s-vesca/Bucaneve_first_try/README.md

# Bucaneve

<p align="center">
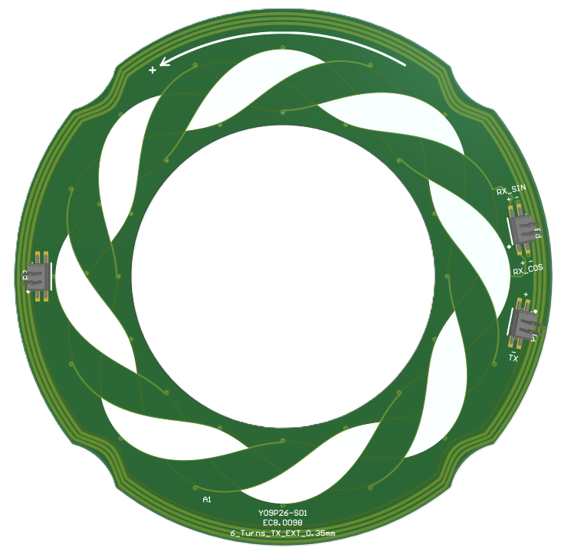
[picture p1: HW/coil_board/coil_board.png]
  
</p>
