s-vesca/Bucaneve_first_try/ppt_tecnomaster/tecnomaster_sensore_IPS.pptx

## Sensore IPS

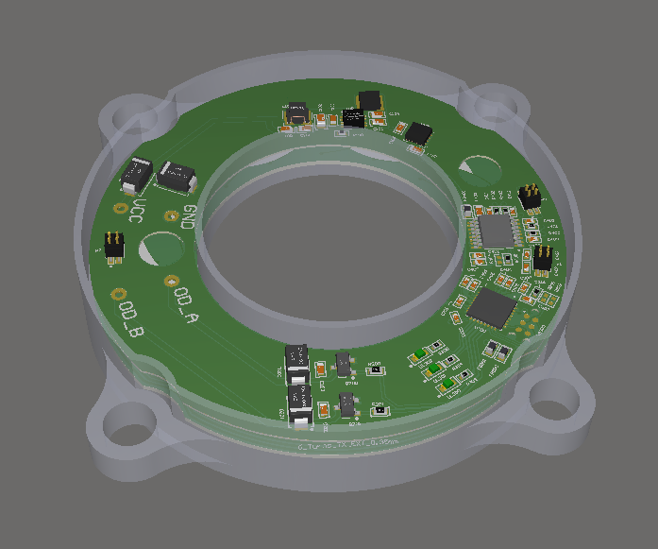
[picture p2: figure]
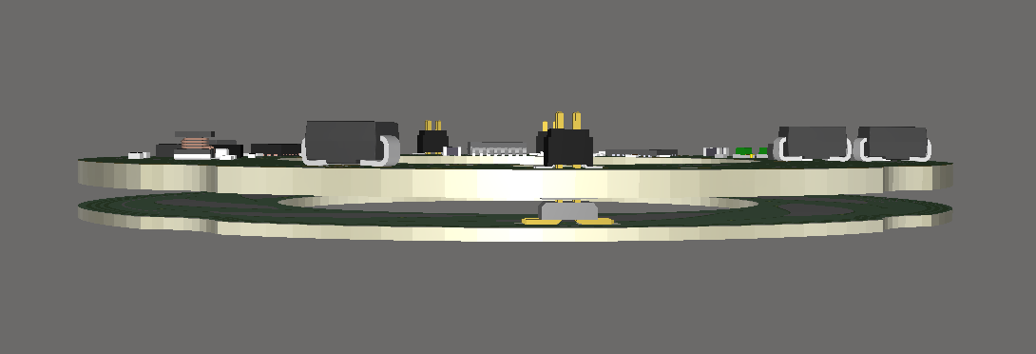
[picture p3: figure]

## Current Stackup

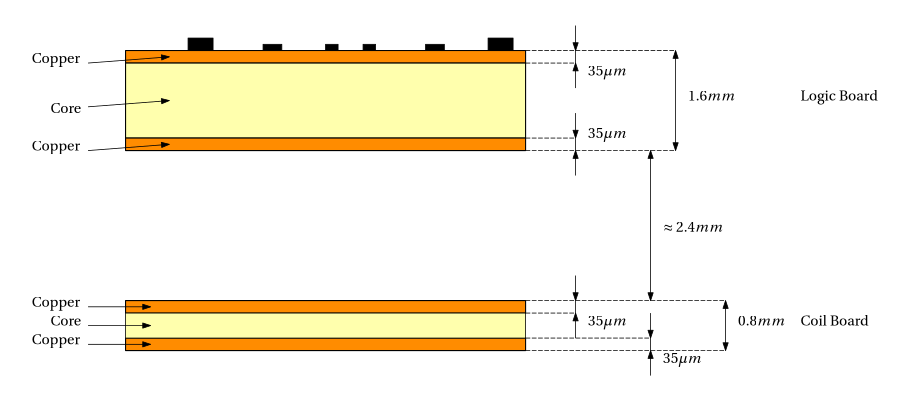
[picture p4: figure]

Cost: _____________________ €/$
(2 x 2 layer boards with all components on top layer)

Coupled via pin-strips

## Proposed Stackup

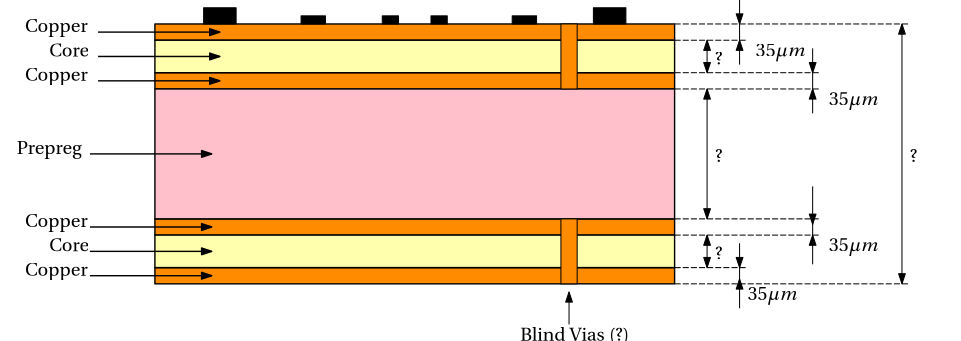
[picture p5: figure]

Maximize (?)

Cost: _____________________ €/$
(1 x 4 layer board with all components on top layer +
Blind vias Top – Inner 1 + Blind vias Inner 2 - Bottom)

Minimize (?)

## Slide 4

Proposed Stackup

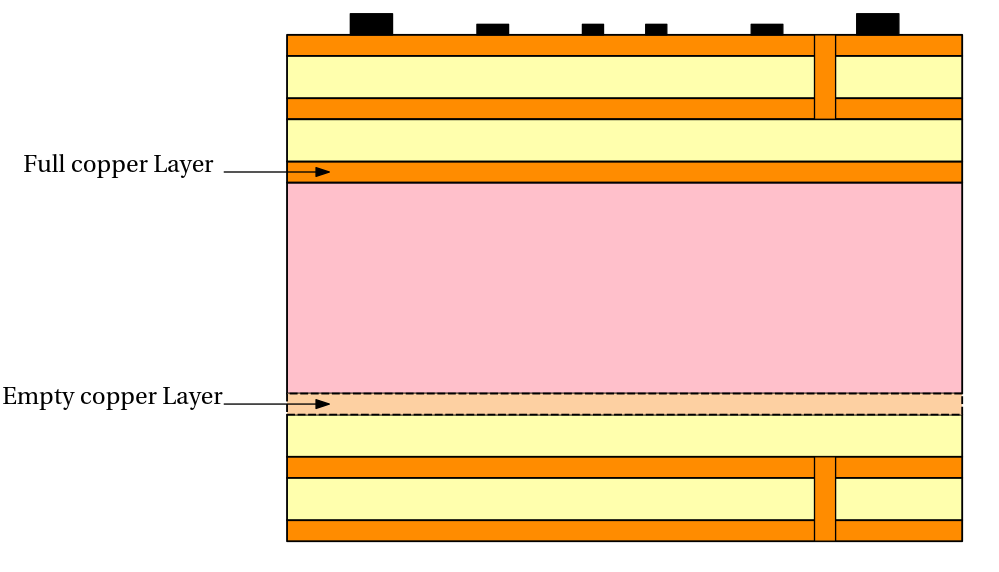
[picture p6: figure]

- Is this considered an asymmetric stackup?
- Is this feasible?

Full GND Plane

Avoid shielding of the coils
