s-vesca/Bucaneve_first_try/HW/logic_board/tc2030.png

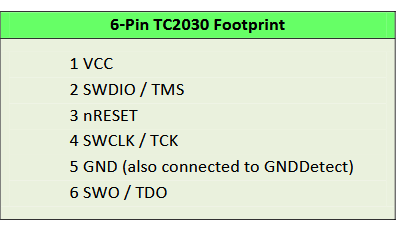
HW/logic_board/tc2030.png
