s-vesca/Bucaneve_first_try/Immagini/boards.png

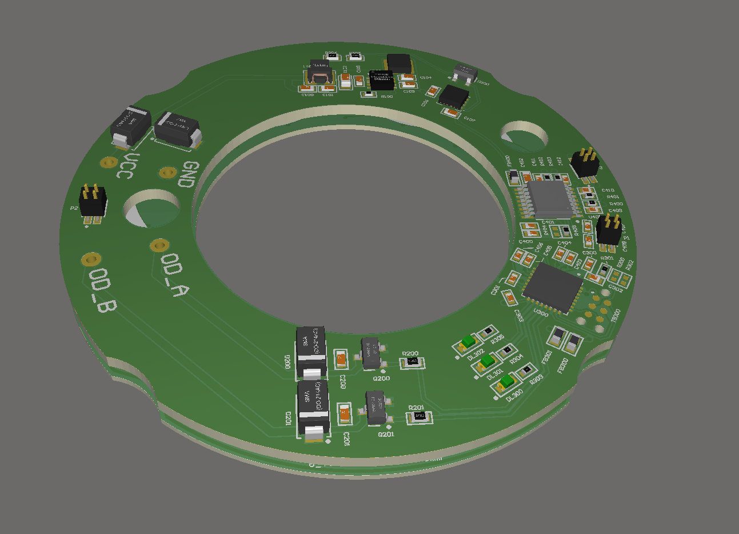
Immagini/boards.png
