s-vesca/Bucaneve_first_try/Immagini/boards_dimensions.png

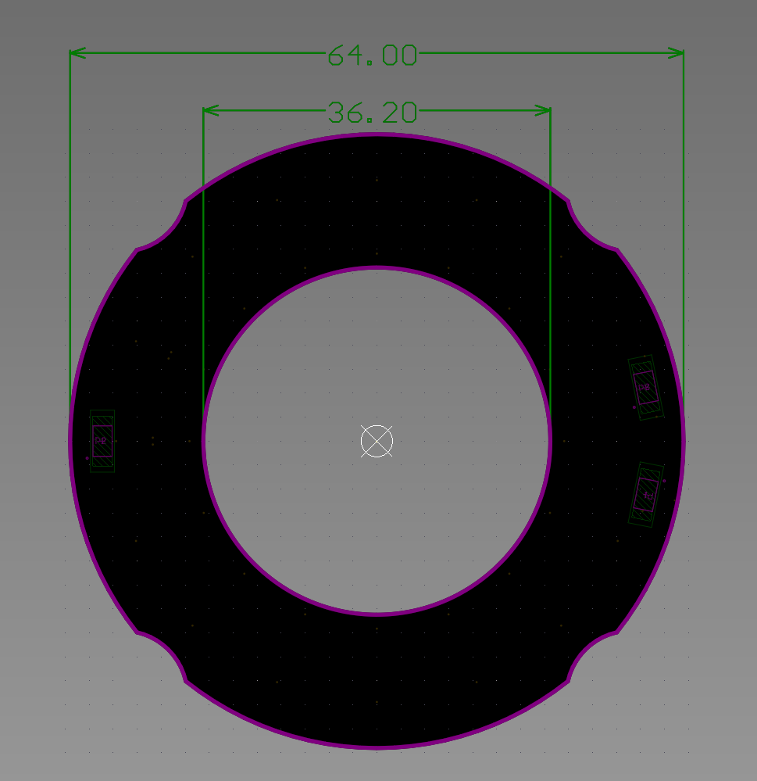
Immagini/boards_dimensions.png
