s-vesca/Bucaneve_first_try/Immagini/MCUViewer_signals.png

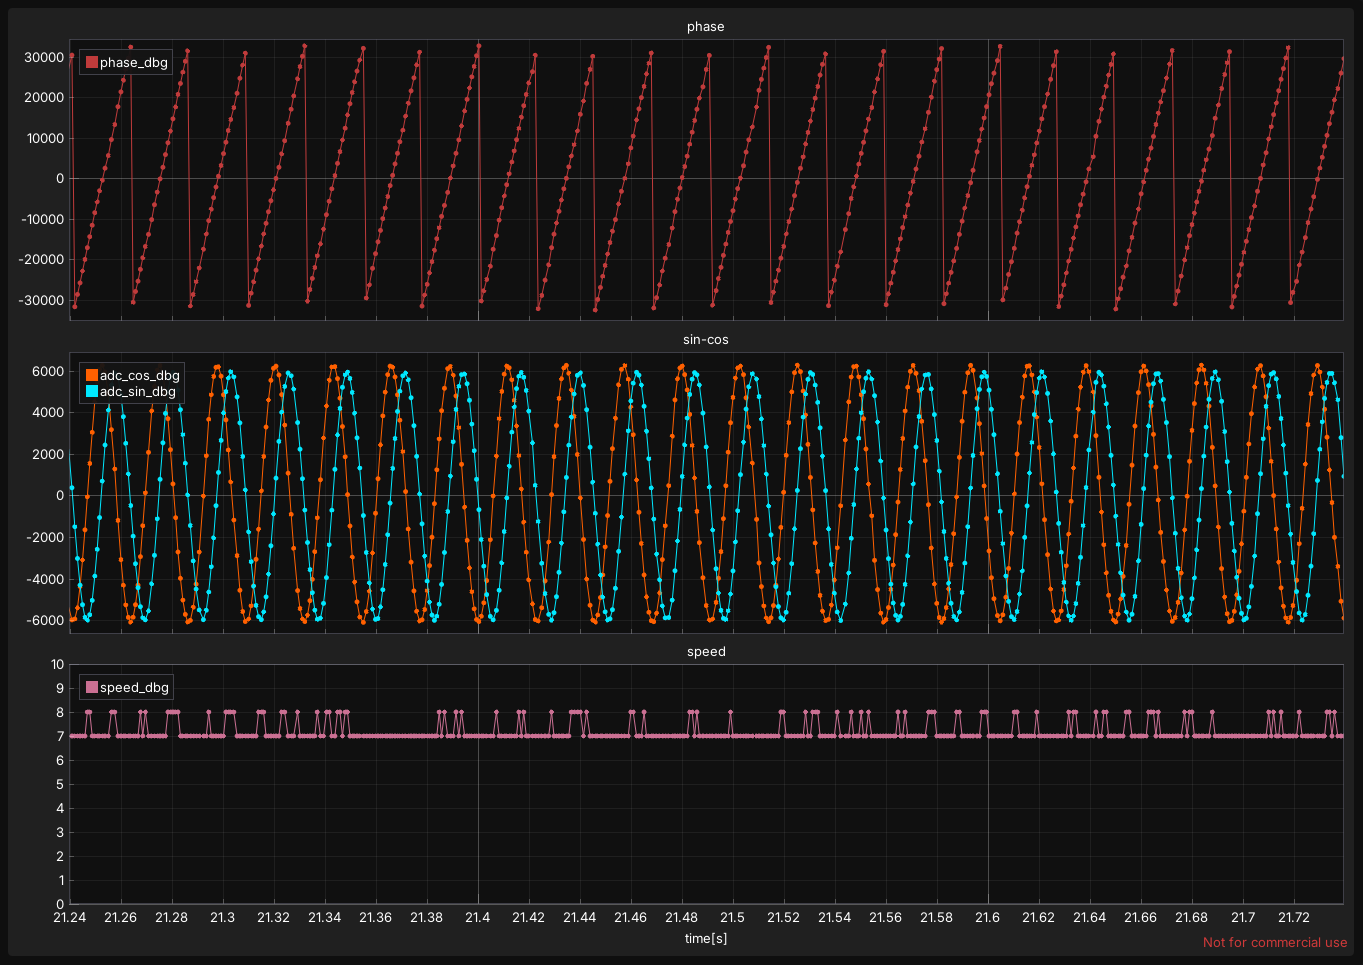
Immagini/MCUViewer_signals.png
