s-vesca/Bucaneve_first_try/Immagini/MCUViewer_xy_cos_sin.png

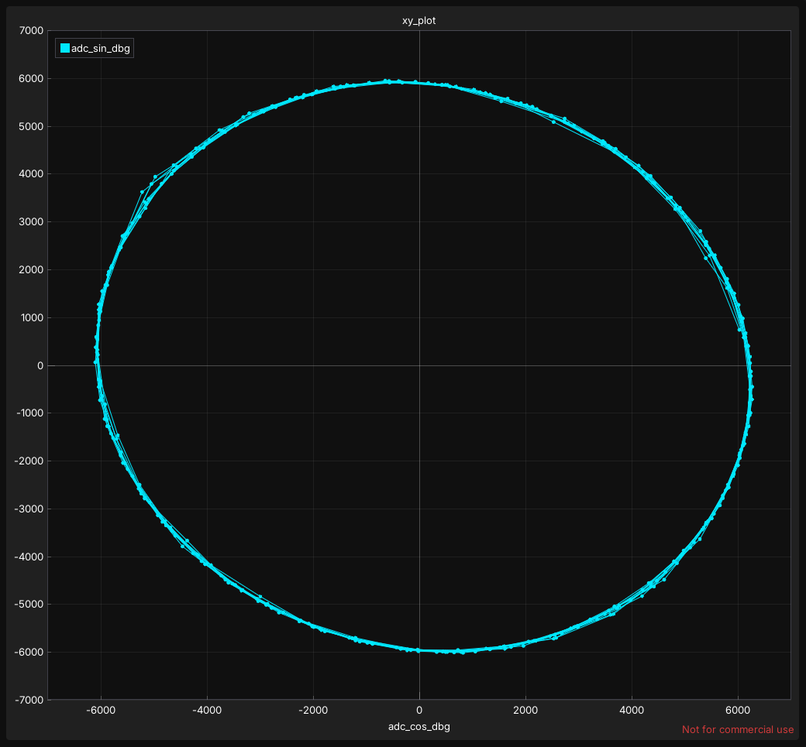
Immagini/MCUViewer_xy_cos_sin.png
