s-vesca/Bucaneve_first_try/Immagini/stackup_bucaneve_1board.png

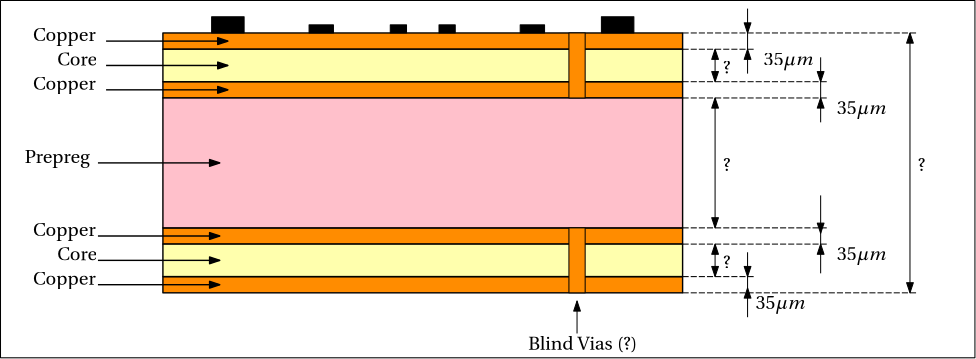
Immagini/stackup_bucaneve_1board.png
