s-vesca/Bucaneve_first_try/Immagini/stackup_bucaneve_1board_6L.png

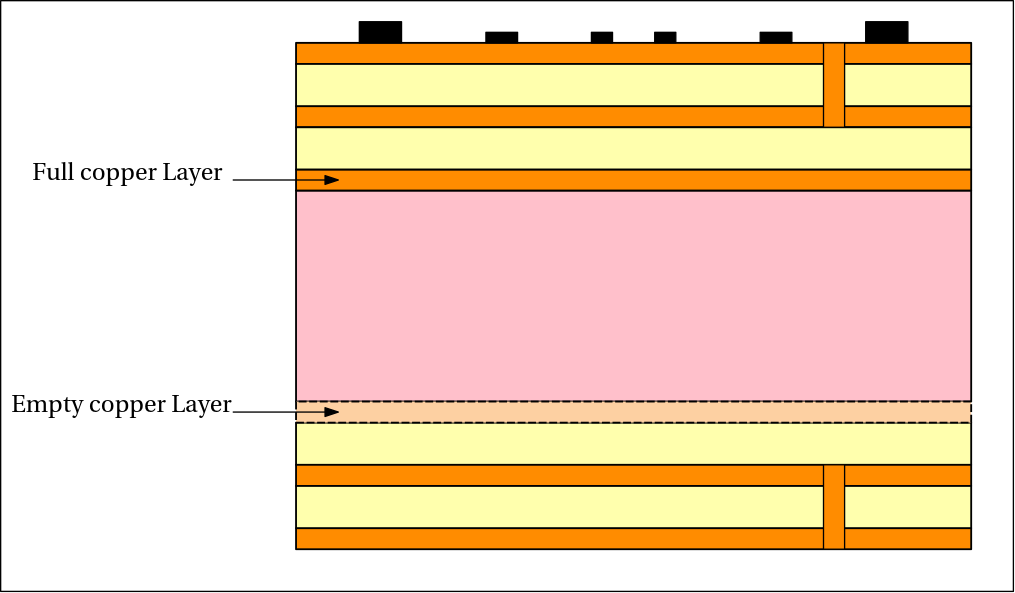
Immagini/stackup_bucaneve_1board_6L.png
