s-vesca/Bucaneve_first_try/HW/ciambellauz_v2.STEP

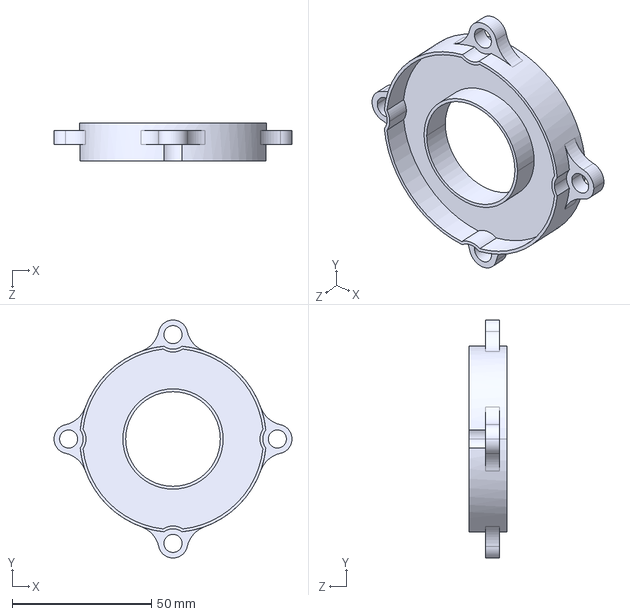
[picture p14: CAD file, 2026-09-03]
HW/ciambellauz_v2.STEP
85.5 x 85.5 x 13.7 mm
