s-vesca/Bucaneve_first_try/(list of files, cad)

Other CAD files:
HW/coil_board/PCB1.DXF
