s-vesca/Bucaneve_first_try/HW/logic_board/logic_board - PrjOut/Base/logic_board_ProjectRevision_Base - Assembly Drawings.PDF

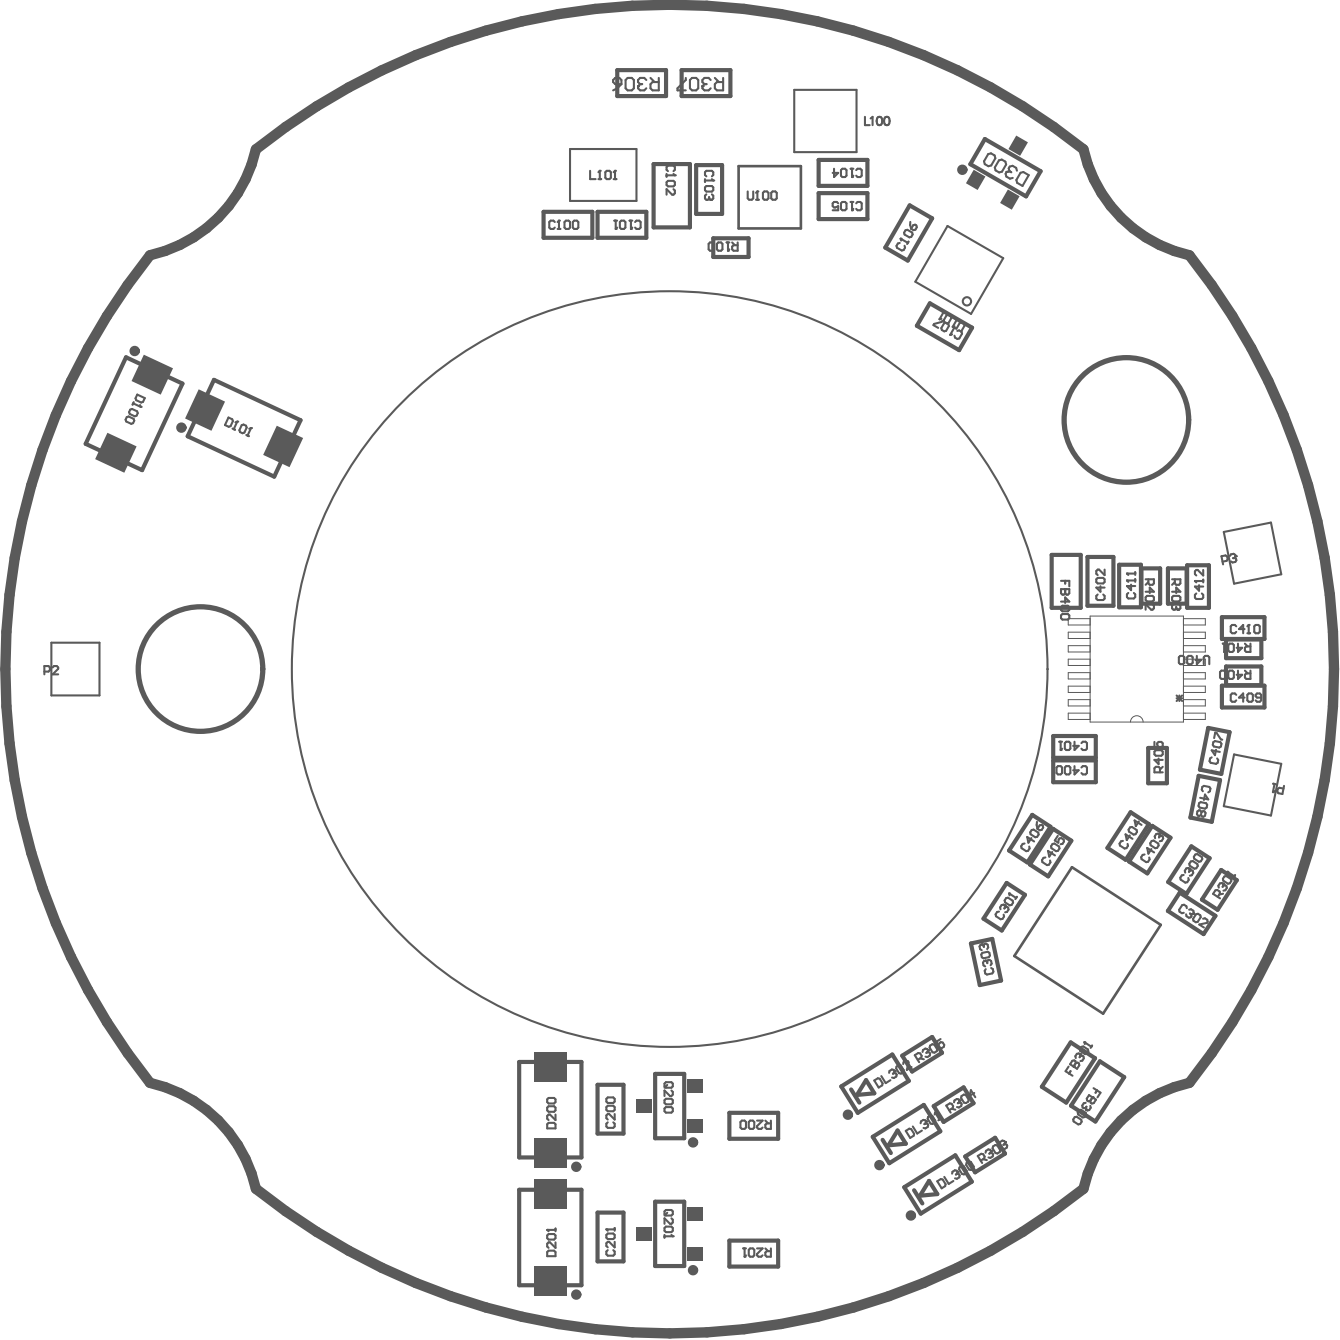
[picture p15: page 1]

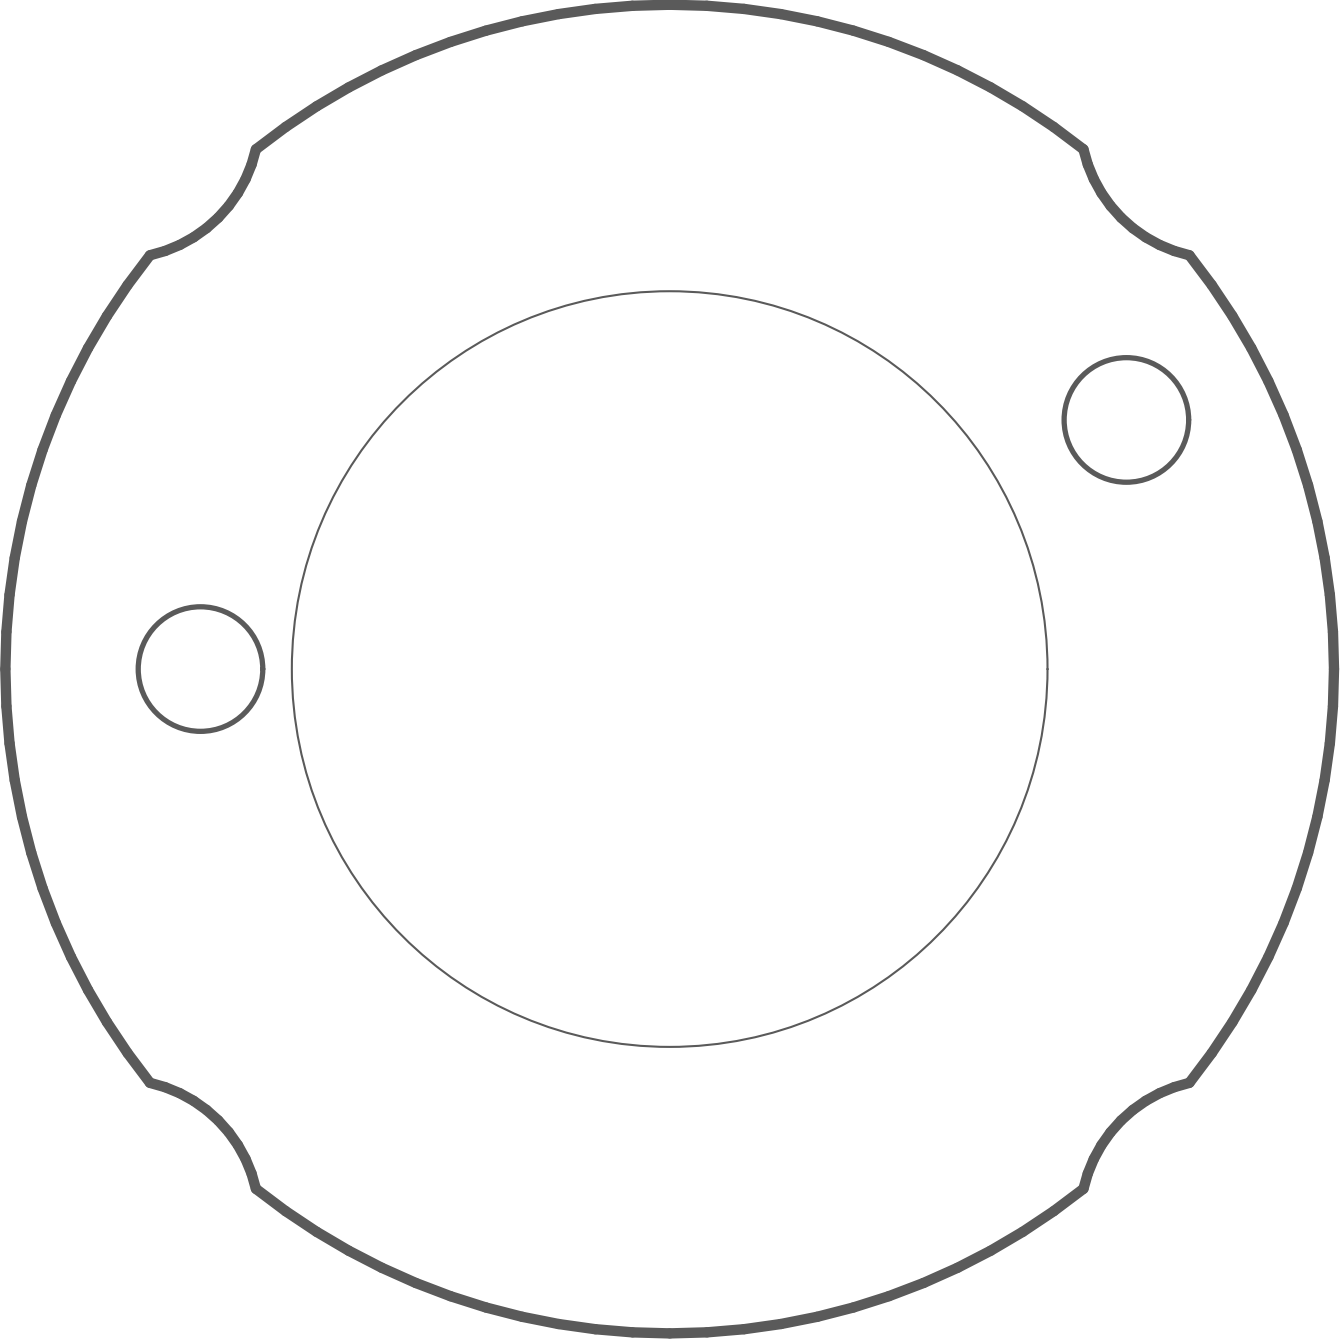
[picture p16: page 2]
