s-vesca/Bucaneve_first_try/HW/logic_board/logic_board - PrjOut/Base/logic_board_ProjectRevision_Base - Schematic Prints.PDF

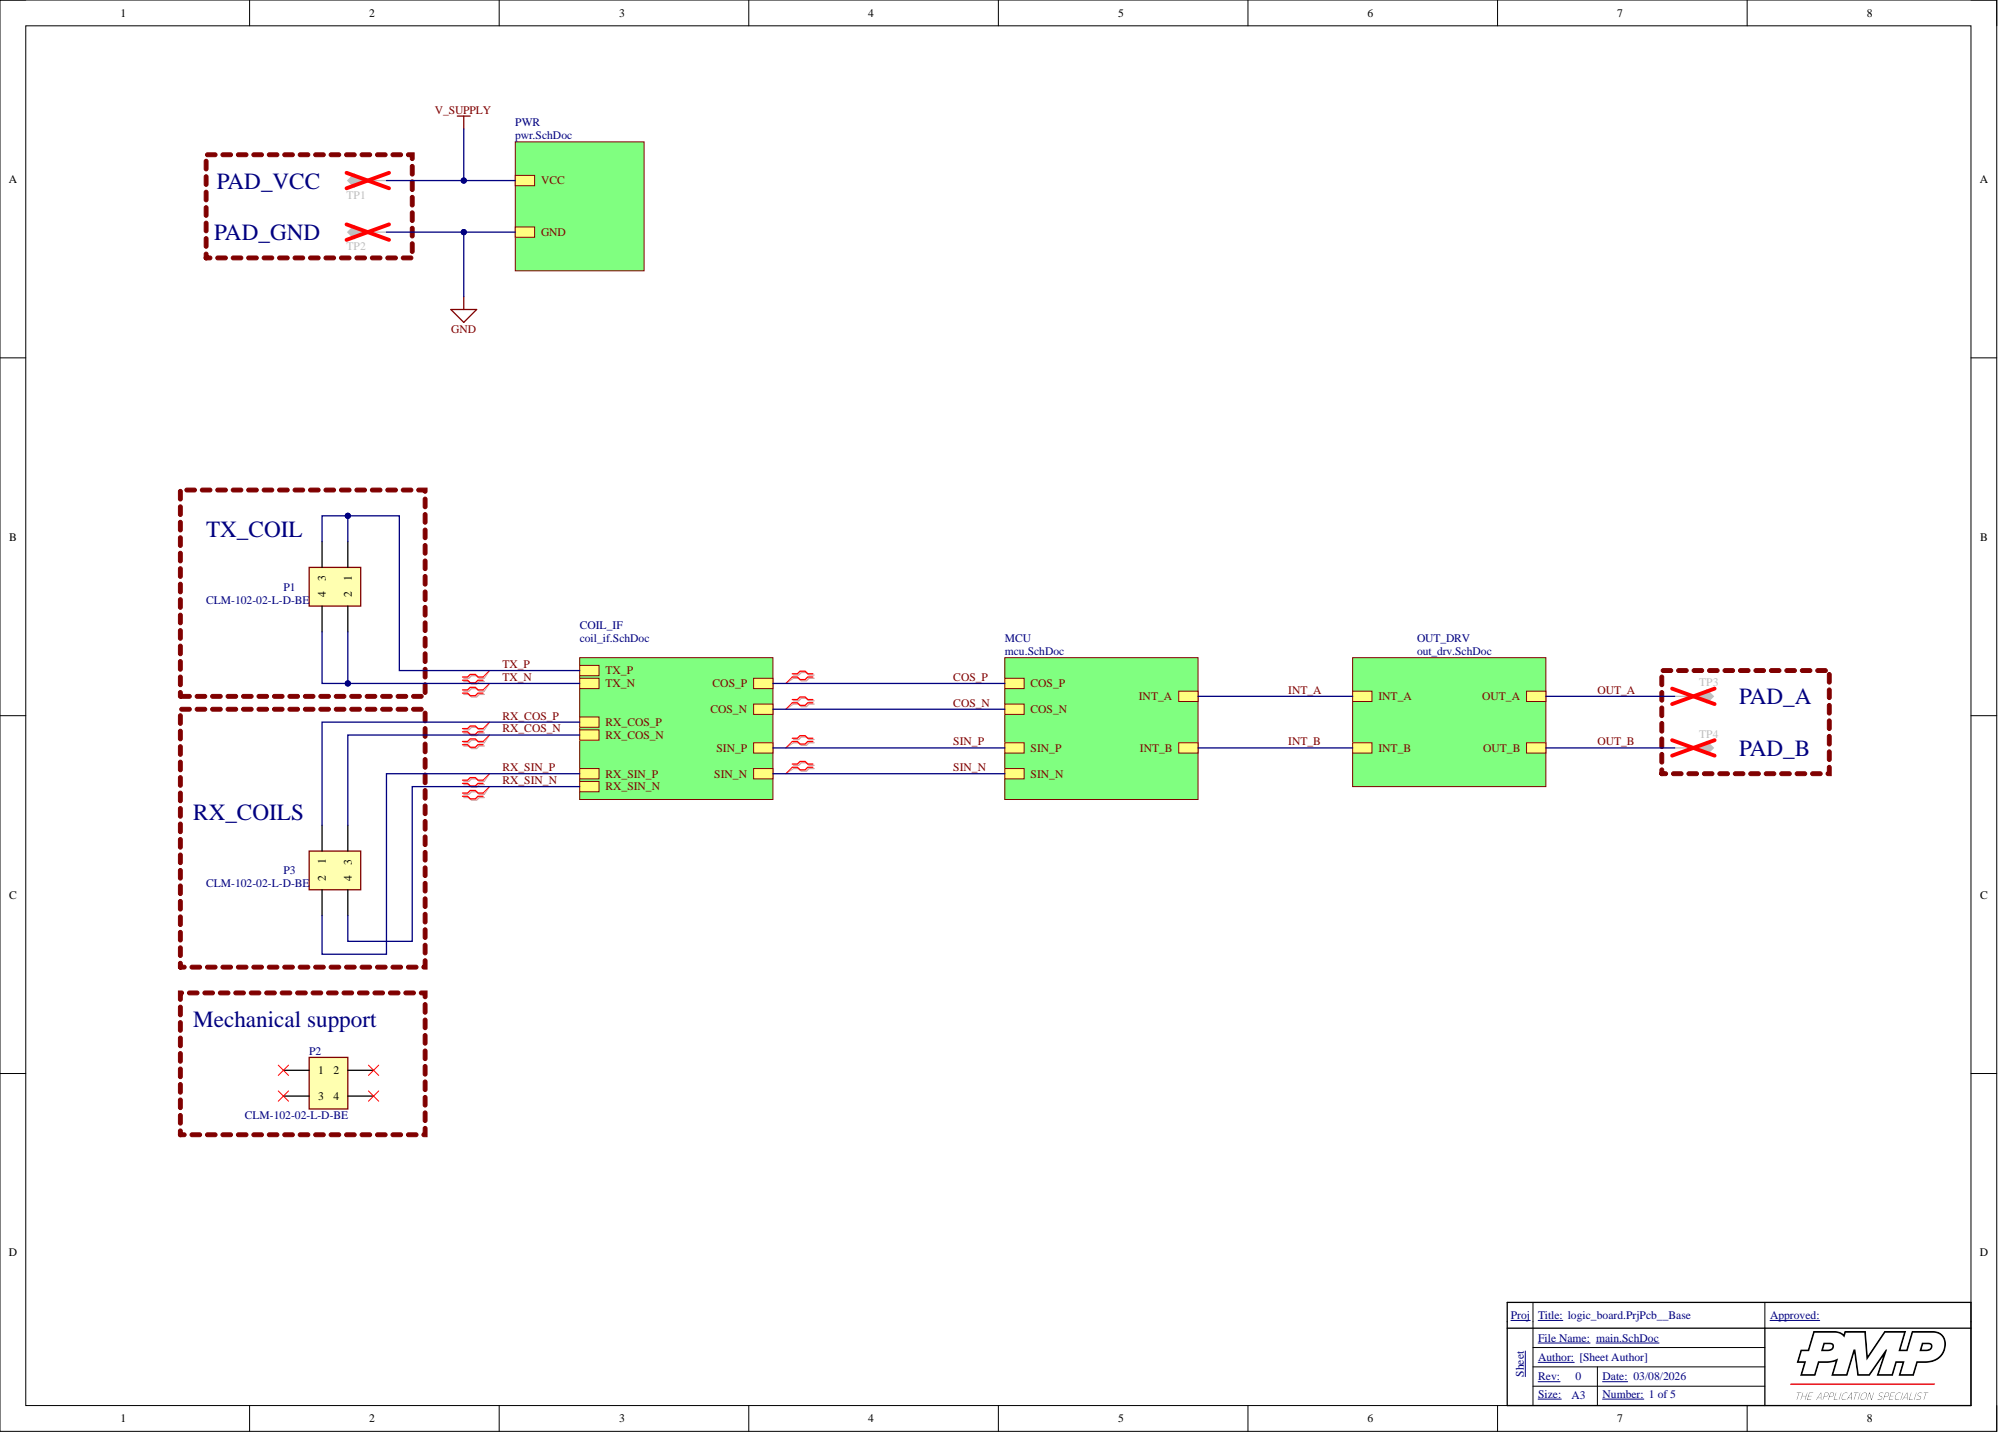
[picture p17: page 1]

File Name: main.SchDoc
Author: [Sheet Author]

Rev: | Date: 03/08/2026
Size: A3 | Number: 1 of 5

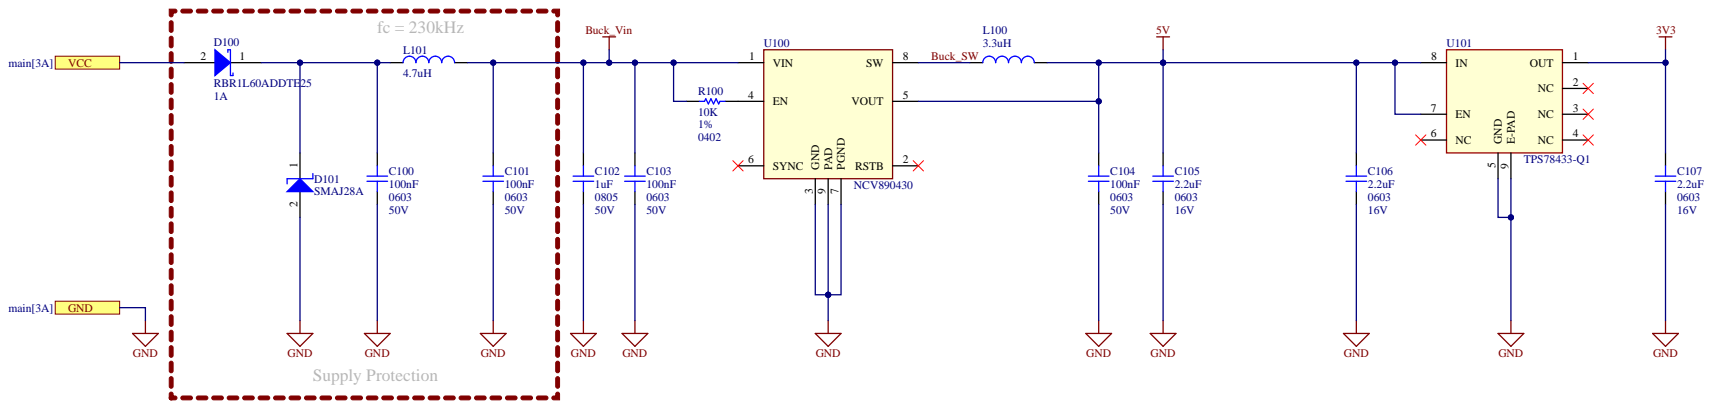
[picture p18: page 2]

File Name: pwr.SchDoc

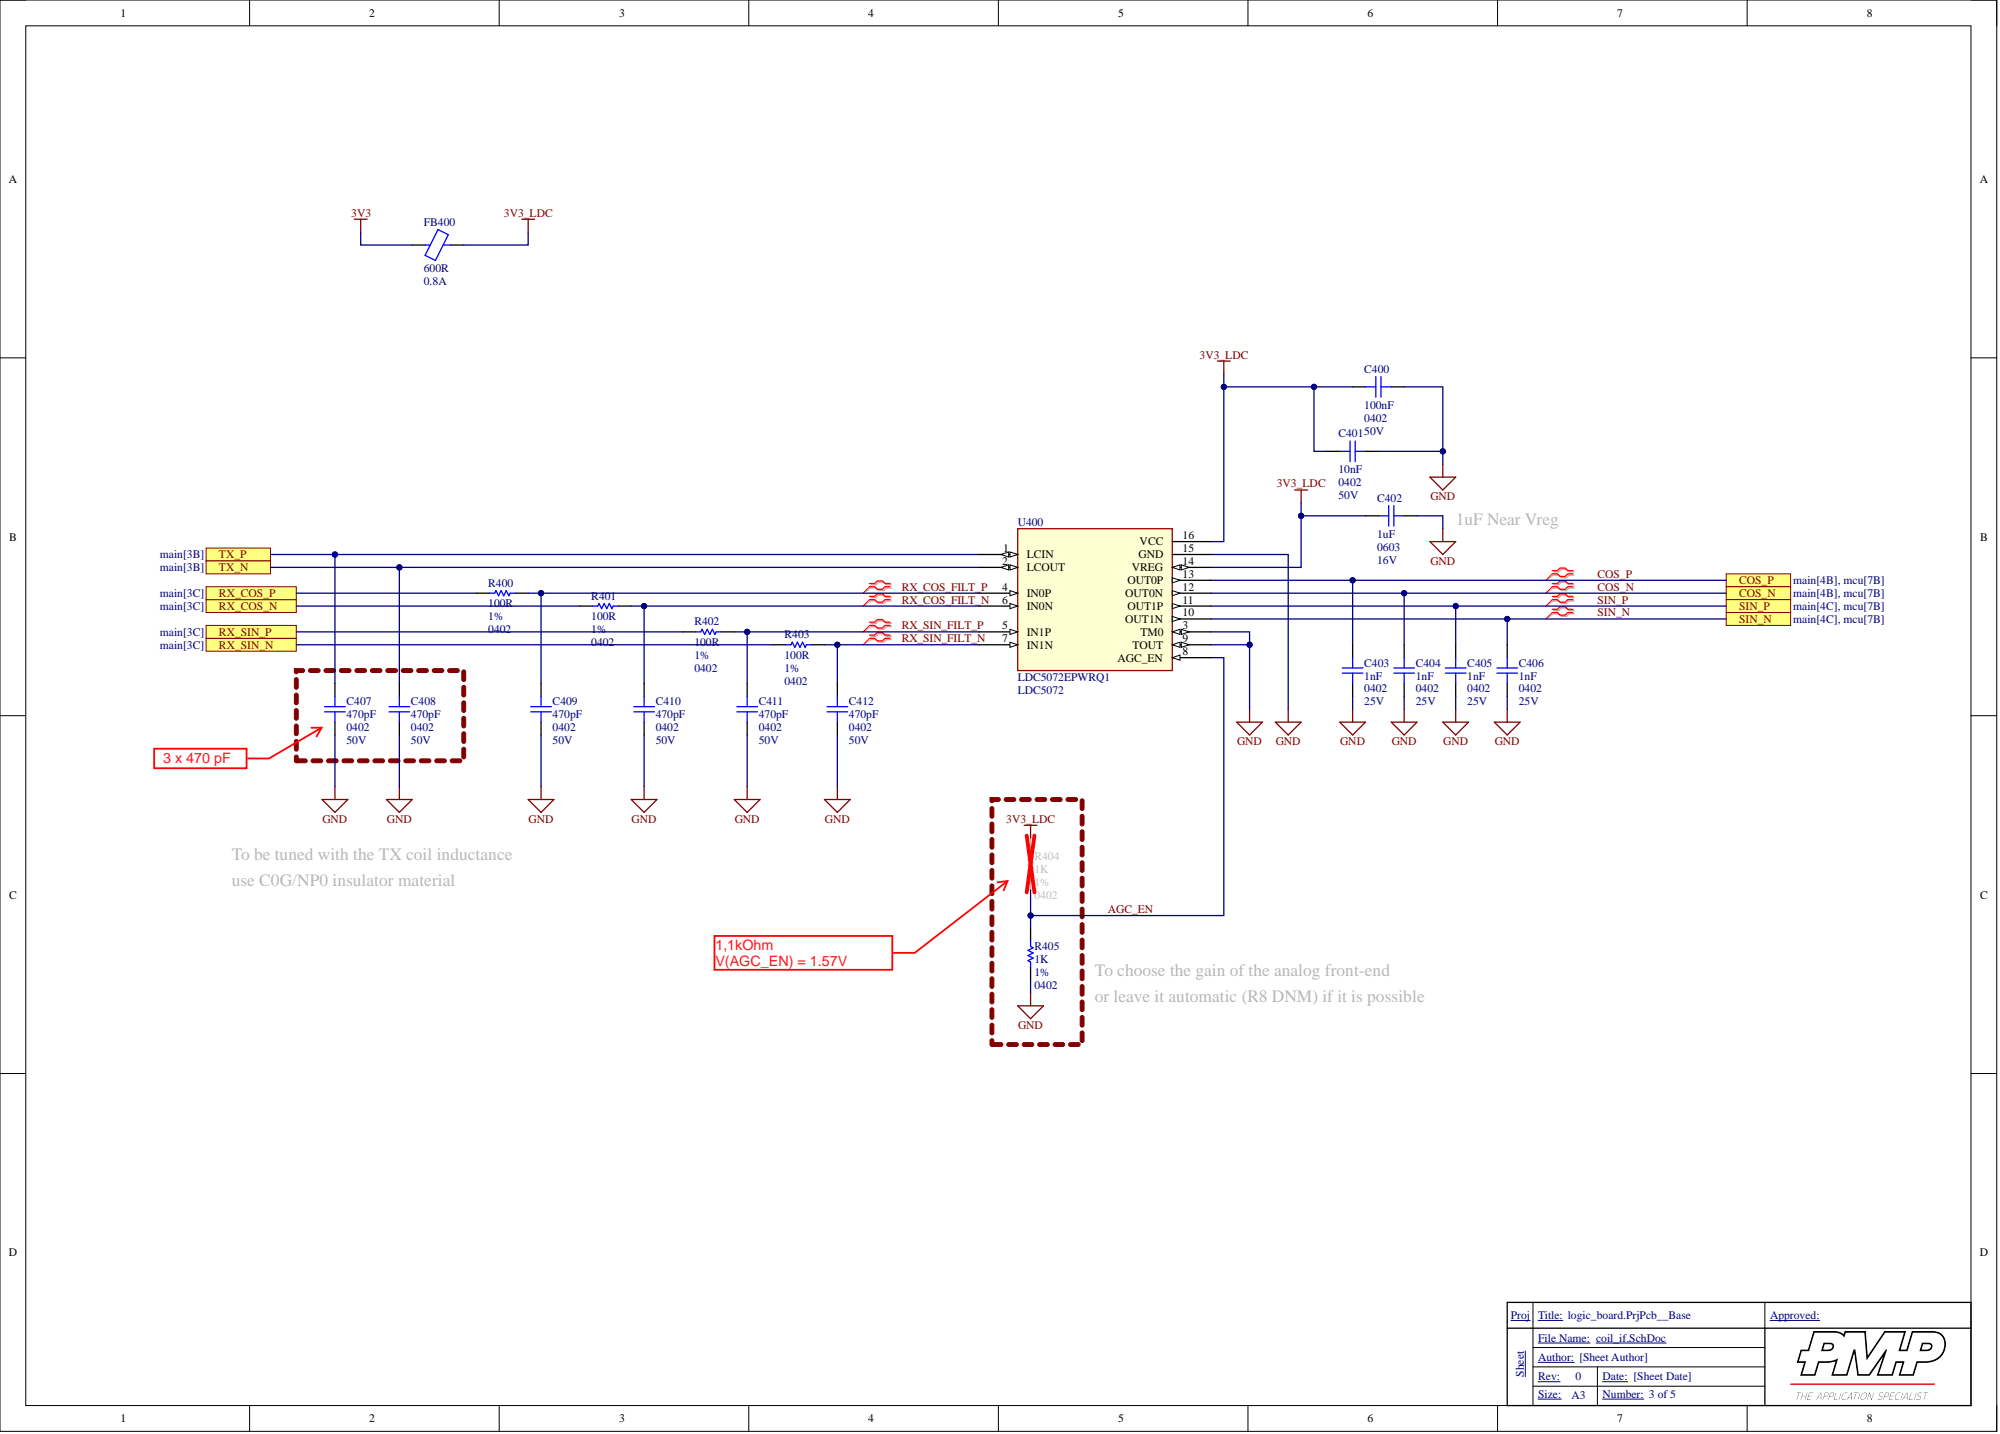
[picture p19: page 3]

COS_N
SIN_P
SIN_N

To be tuned with the TX coil inductance
use C0G/NP0 insulator material

To choose the gain of the analog front-end
or leave it automatic (R8 DNM) if it is possible

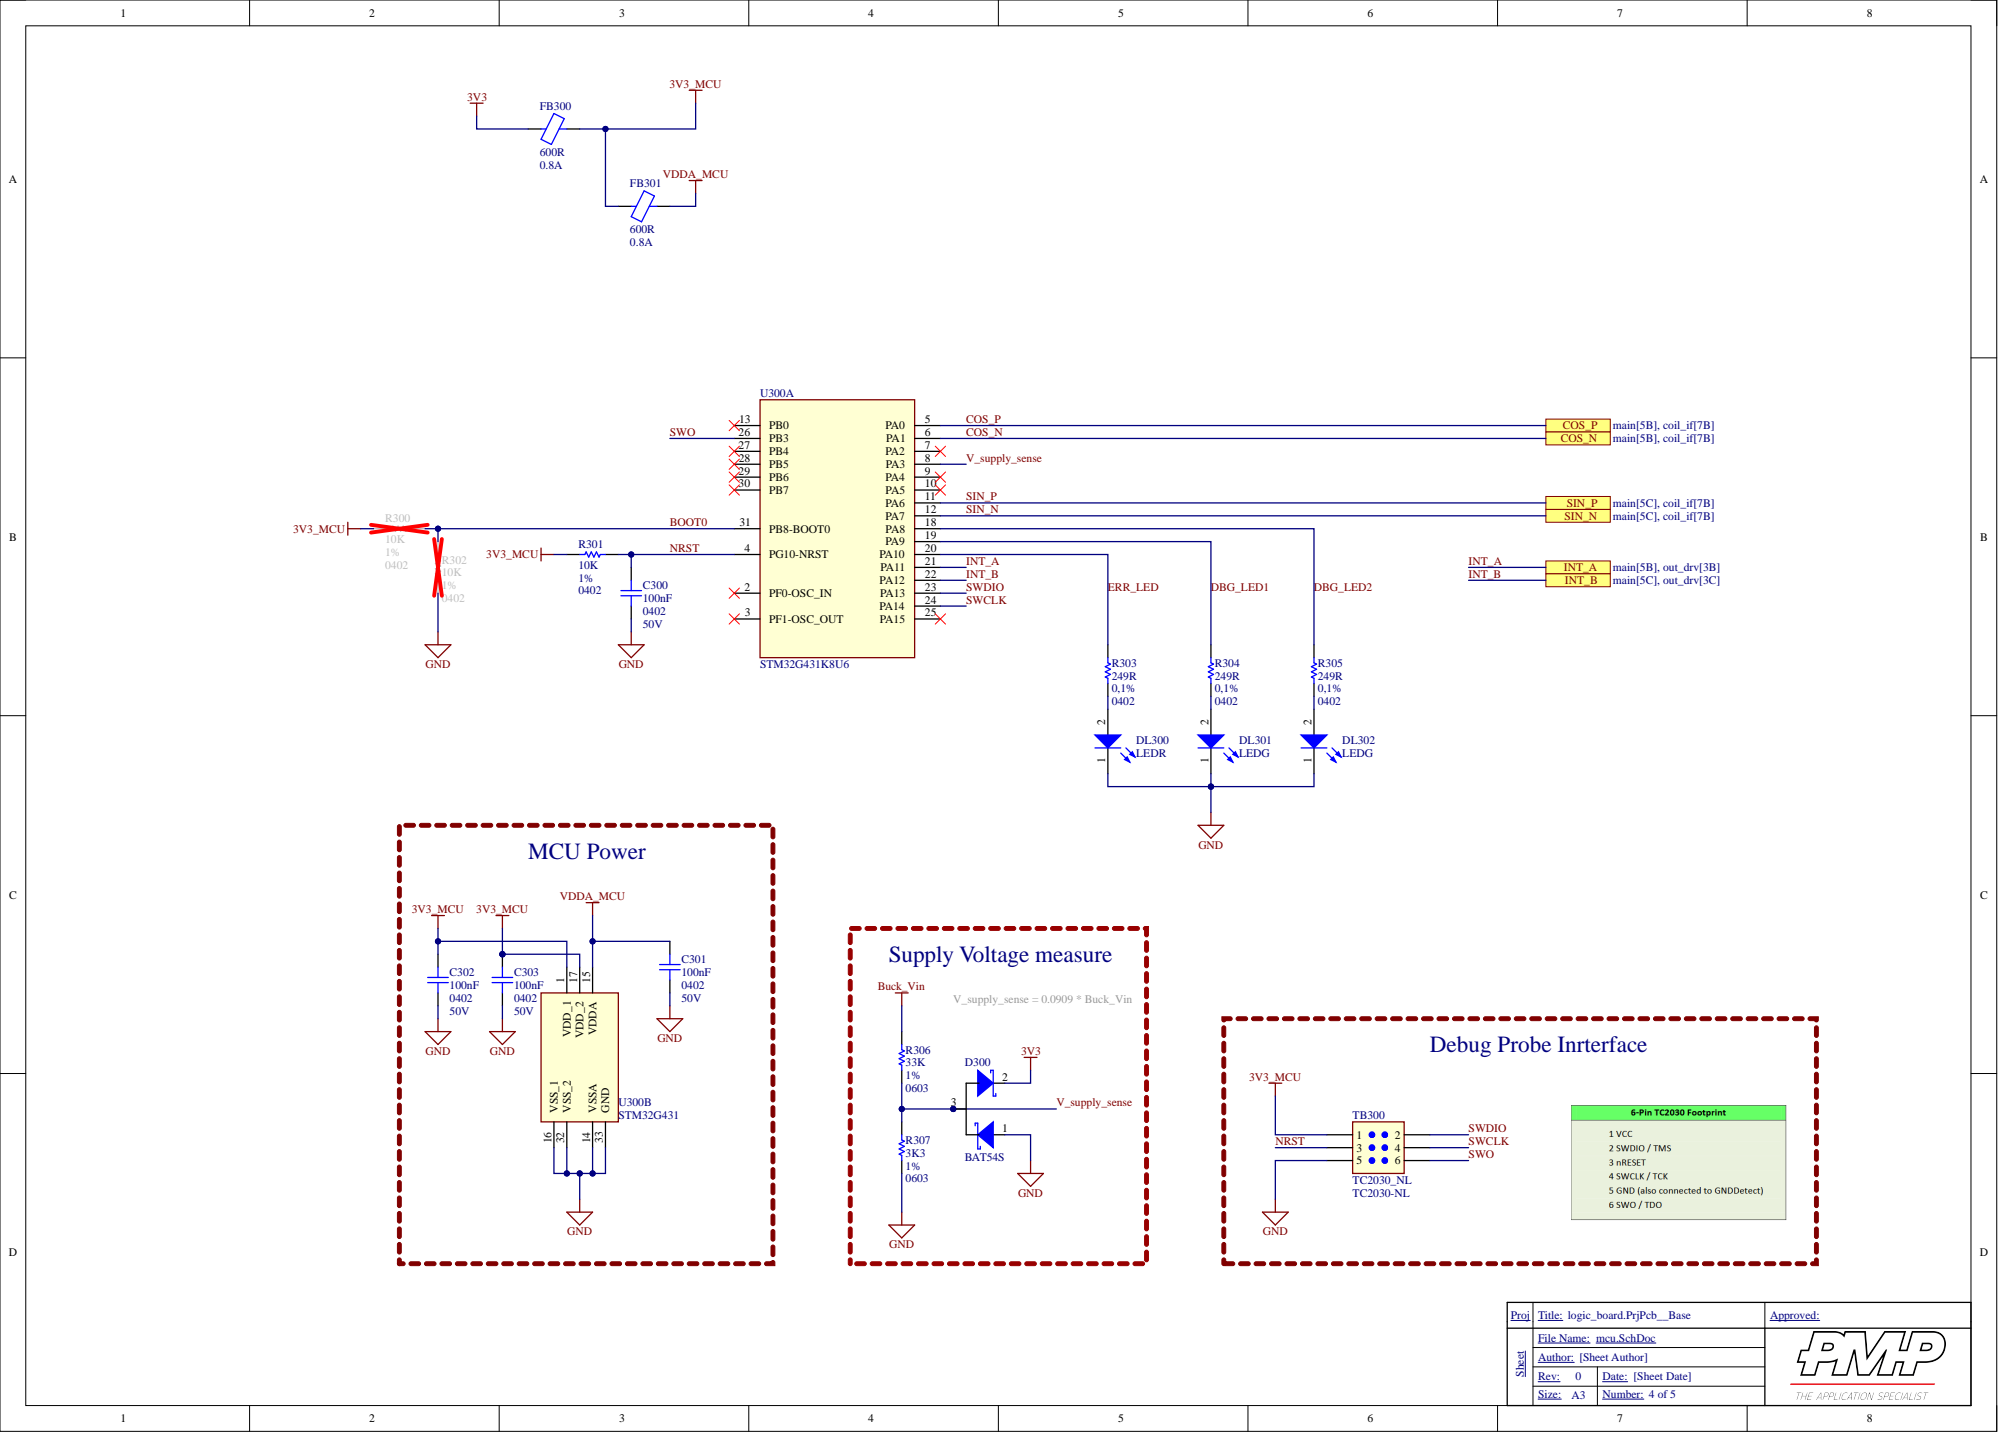
[picture p20: page 4]

File Name: mcu.SchDoc

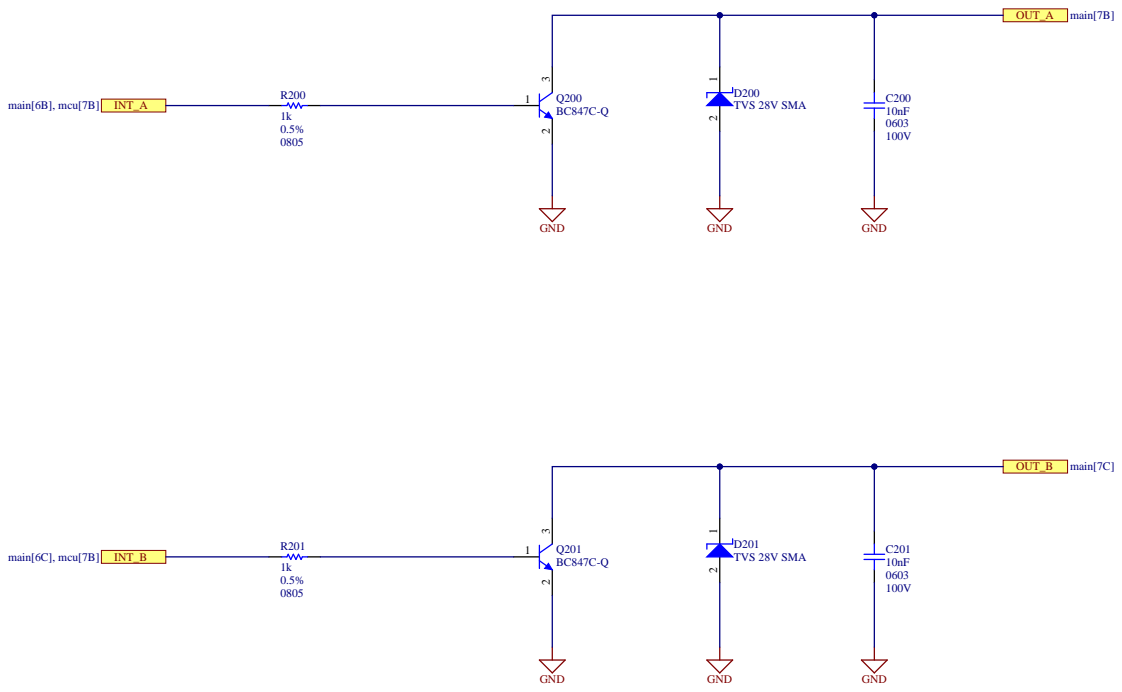
[picture p21: page 5]
