s-vesca/Bucaneve_first_try/(list of files, drawings)

Other design files:
HW/coil_board/coil_board.PrjPcb
HW/coil_board/main.SchDoc
HW/coil_board/PCB1.PcbDoc
HW/logic_board/coil_if.SchDoc
HW/logic_board/logic_board.PrjPcb
HW/logic_board/main.SchDoc
HW/logic_board/mcu.SchDoc
HW/logic_board/out_drv.SchDoc
HW/logic_board/PCB1_w_gnd_plane.PcbDoc
HW/logic_board/PCB1_wo_gnd_plane.PcbDoc
HW/logic_board/pwr.SchDoc
