s-vesca/Bucaneve_first_try/FW/G431_32/Core/Inc/main.h

#define TIM7_PSC 0
#define TIM7_ARR 16999
#define ADC_OFFSET_DEFAULT 2048
#define TIM2_ARR 213
#define COS_P_Pin LL_GPIO_PIN_0
#define COS_P_GPIO_Port GPIOA
#define COS_N_Pin LL_GPIO_PIN_1
#define COS_N_GPIO_Port GPIOA
#define VDC_SENSE_Pin LL_GPIO_PIN_3
#define VDC_SENSE_GPIO_Port GPIOA
#define SIN_P_Pin LL_GPIO_PIN_6
#define SIN_P_GPIO_Port GPIOA
#define SIN_N_Pin LL_GPIO_PIN_7
#define SIN_N_GPIO_Port GPIOA
#define DBG_LED2_Pin LL_GPIO_PIN_8
#define DBG_LED2_GPIO_Port GPIOA
#define DBG_LED1_Pin LL_GPIO_PIN_9
#define DBG_LED1_GPIO_Port GPIOA
#define ERR_LED_Pin LL_GPIO_PIN_10
#define ERR_LED_GPIO_Port GPIOA
#define INT_A_Pin LL_GPIO_PIN_11
#define INT_A_GPIO_Port GPIOA
#define INT_B_Pin LL_GPIO_PIN_12
#define INT_B_GPIO_Port GPIOA
#define SWDIO_Pin LL_GPIO_PIN_13
#define SWDIO_GPIO_Port GPIOA
#define SWCLK_Pin LL_GPIO_PIN_14
#define SWCLK_GPIO_Port GPIOA
#define SWO_Pin LL_GPIO_PIN_3
#define SWO_GPIO_Port GPIOB
