s-vesca/Bucaneve_first_try/FW/G431_32/App/Inc/output_generator.h

#ifndef OUTPUT_GENERATOR_H
#define OUTPUT_GENERATOR_H
#include <stdint.h>

void output_generator_init(uint16_t _factor);

//__attribute__((section(".ccm_code")))
void calculate_outputs();

#endif //OUTPUT_GENERATOR_H
