s-vesca/Bucaneve_first_try/(commit log)

2026-09-09 error led
2026-09-10 first boot of logic board + analog offsets calibration
2026-09-11 added images corrected stackup of logic board
    [PCB1_w_gnd_plane.PcbDoc, PCB1_wo_gnd_plane.PcbDoc]
2026-09-15 tested and calibrated on RS bench
