s-vesca/Bucaneve_first_try/(notices)

Notices in the files:
FW/G431_32/Core/Inc/main.h:
Copyright (c) 2026 STMicroelectronics.
All rights reserved.
This software is licensed under terms that can be found in the LICENSE file
